sylvaing/PoolMaster/Nextion/HMI2_Calibs.png

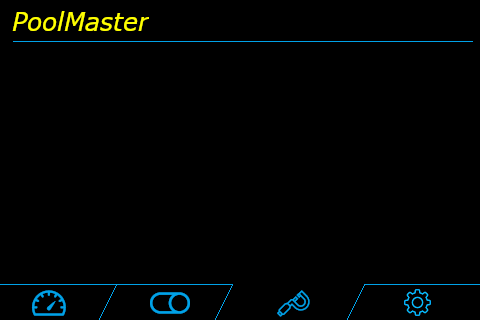
Nextion/HMI2_Calibs.png
