sylvaing/PoolMaster/Nextion/HMI2_Home.png

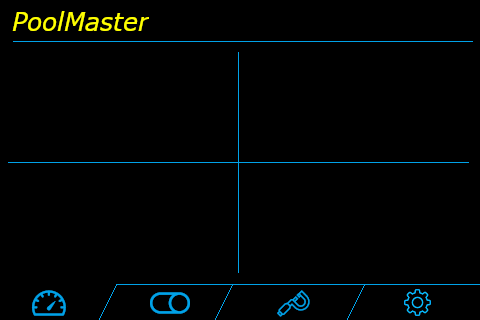
Nextion/HMI2_Home.png
