sylvaing/PoolMaster/(commit log)

2020-05-29 Add Boris feature with button tap and double tap
2020-05-29 use button activeLow instead of activeHigh
