sylvaing/PoolMaster/(notices)

Notices in the files:
source/PoolMaster/DebugUtils.h:
This program is free software: you can redistribute it and/or modify
it under the terms of the version 3 GNU General Public License as
published by the Free Software Foundation.
